alihancakir/TEKNOFEST-2023-SEMI-ALTITUDE-ROCKET-COMPETITION/AVIYONIC_MOSFET.png

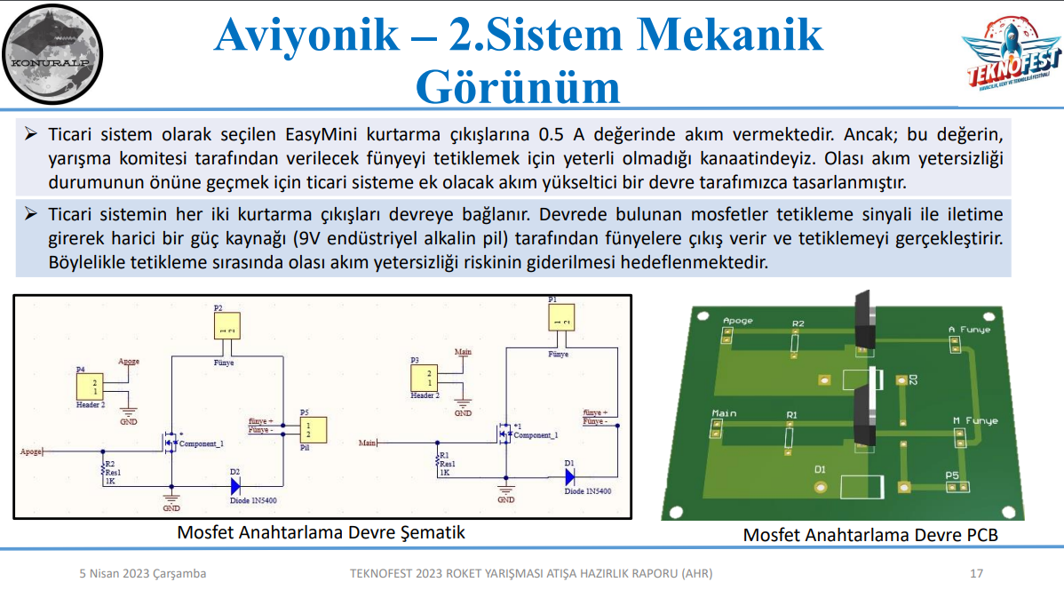
AVIYONIC_MOSFET.png
