alihancakir/TEKNOFEST-2023-SEMI-ALTITUDE-ROCKET-COMPETITION/AVIYONIC_SCHEMATIC.png

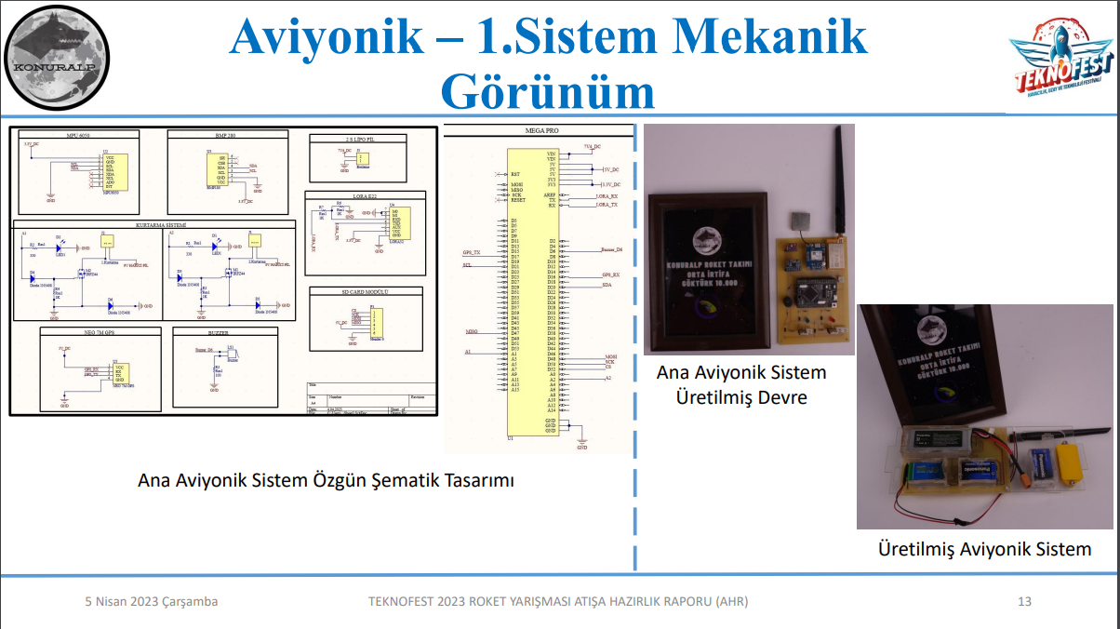
AVIYONIC_SCHEMATIC.png
