alihancakir/TEKNOFEST-2023-SEMI-ALTITUDE-ROCKET-COMPETITION/AVIYONICS.jpg

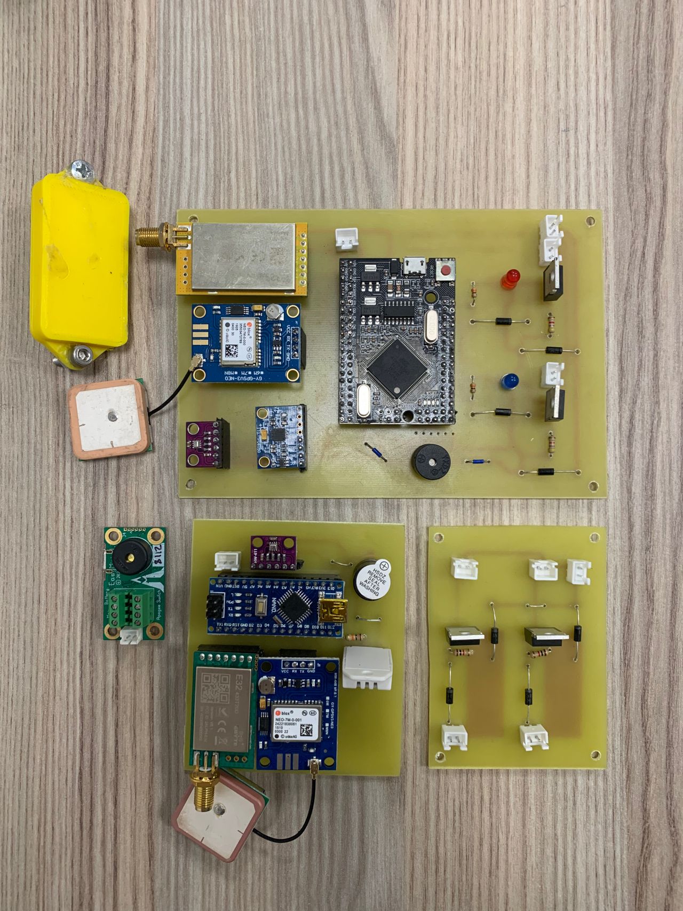
AVIYONICS.jpg
