alihancakir/TEKNOFEST-2023-SEMI-ALTITUDE-ROCKET-COMPETITION/AVIYONIC_TEST.png

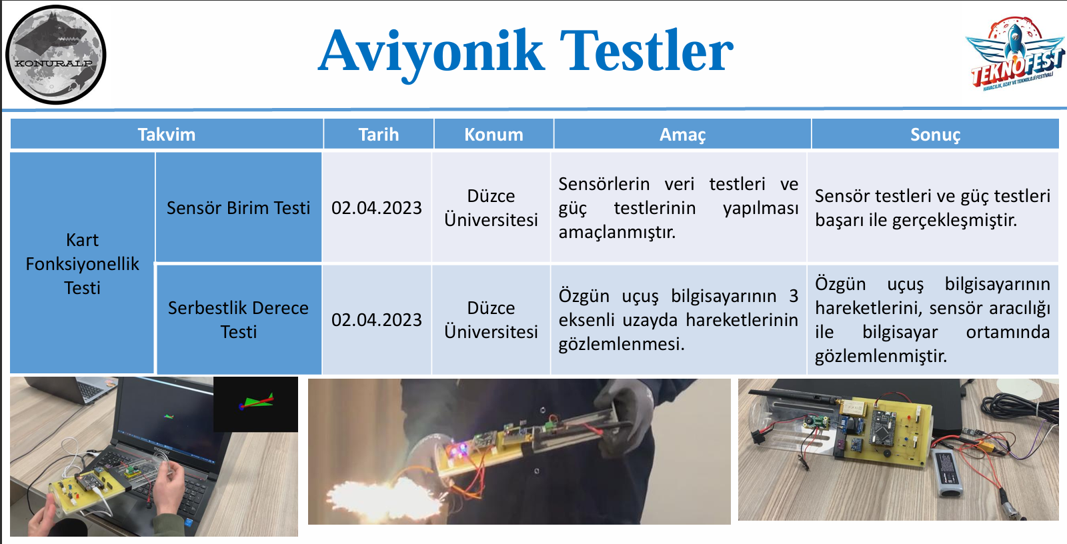
AVIYONIC_TEST.png
